billy-bertrand/My-First-Robot/code/round-1/Round-1 UML Interaction Diagram.png

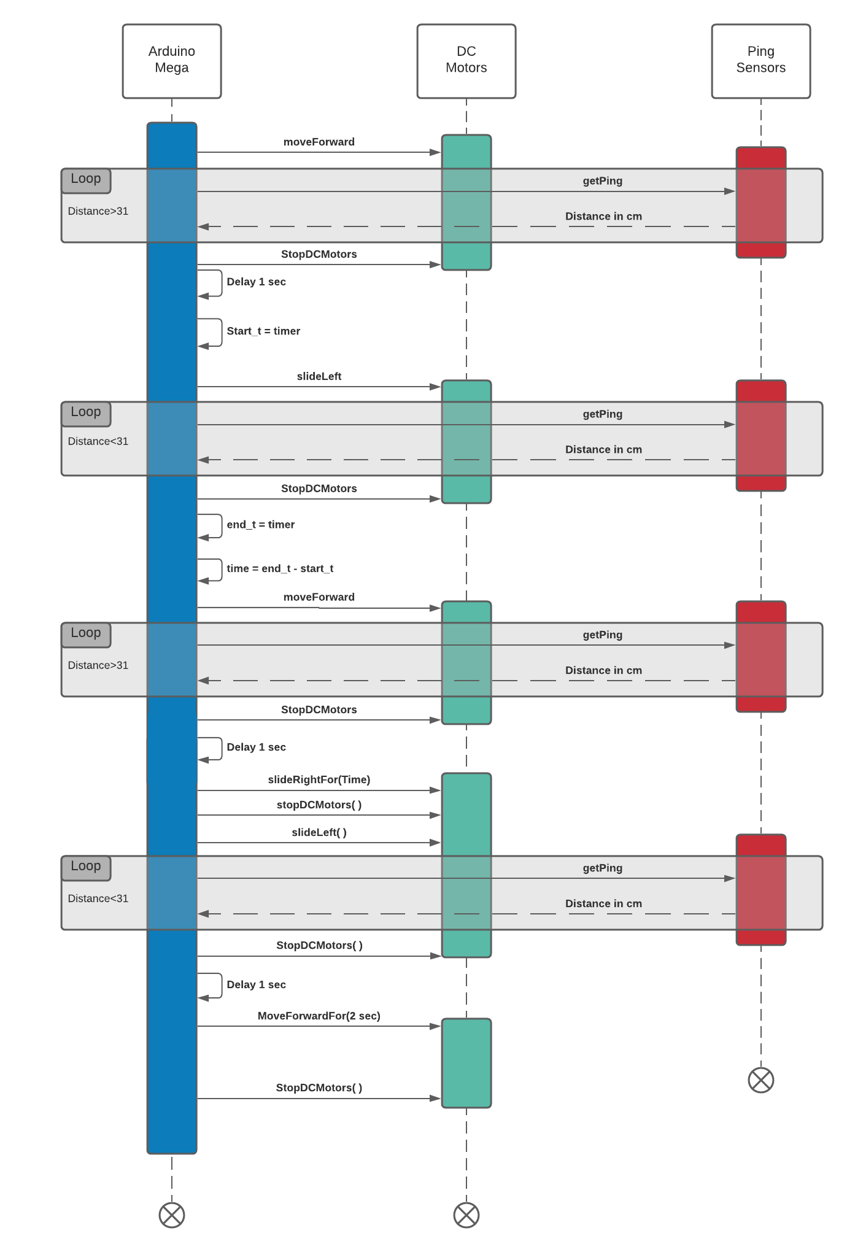
code/round-1/Round-1 UML Interaction Diagram.png
