billy-bertrand/My-First-Robot/etc/Inked-Crash Map-cropped.jpg

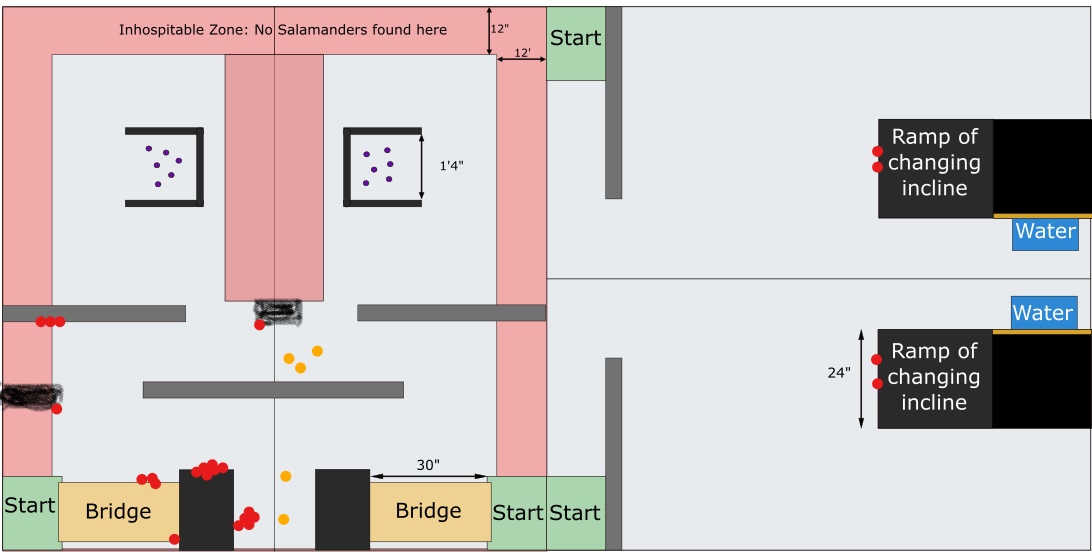
etc/Inked-Crash Map-cropped.jpg
