billy-bertrand/My-First-Robot/etc/Before-calibration.gif

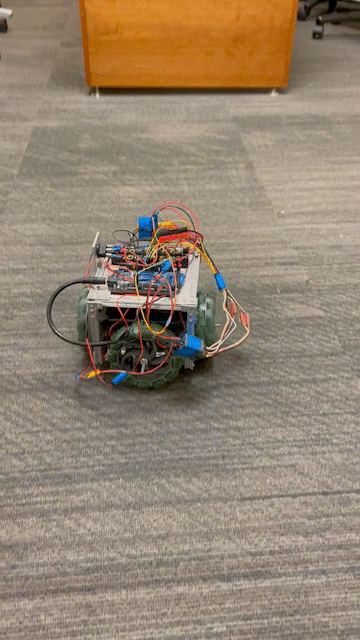
etc/Before-calibration.gif
